bobbymckinney/hall_measurement/README.md

# hall_measurement

This project is for the measurement of the hall coefficient and carrier concentration of thermoelectric materials.
