bobbymckinney/hall_measurement/setup/Matrix Card Schematic.pptx

Resistivity/Hall Effect Matrix Card – Keithley 7709

Wiring Color Code
A – Red
B – Black
C – Blue
D – Green
I – White
V – Yellow

- Row/Column

- Channel

- Wiring Pin

(#)

A

C

Sample

B

D

Hi

(24)

(08)

1

Lo

Hi

(41)

2

(25)

Lo

Hi

(26)

3

(10)

Lo

Hi

(43)

4

(27)

Lo

Hi

(28)

5

(12)

Lo

Hi

(45)

6

(29)

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
(35)

(19)

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
(20)

(04)

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
## Slide 2

Resistivity Measurement Sequence – RAB, CD

1. Current Off
2. Short Card – Close 17, 25, 26, 27, 28, 29, 30
3. Prepare Measurement - Open 25, 27, 28, 29, 30
4. Current On, Delay, Measure Voltage
5. Current Reverse, Delay, Measure Voltage
6. Current Off
7. Short Card – Close 25, 27, 28, 29, 30

## Slide 3

Resistivity Measurement Sequence – RCD, AB

1. Current Off
2. Short Card – Close 17, 25, 26, 27, 28, 29, 30
3. Prepare Measurement – Close 18
4. Prepare Measurement – Open 17, 26, 27, 28, 29, 30
5. Current On, Delay, Measure Voltage
6. Current Reverse, Delay, Measure Voltage
7. Current Off
8. Short Card – Close 17, 26, 27, 28, 29, 30
9. Finish – Open 18

## Slide 4

Resistivity Measurement Sequence – RAC,BD

1. Current Off
2. Short Card – Close 17, 25, 26, 27, 28, 29, 30
3. Prepare Measurement – Close 19
4. Prepare Measurement – Open 17, 25, 26, 27, 29, 30
5. Current On, Delay, Measure Voltage
6. Current Reverse, Delay, Measure Voltage
7. Current Off
8. Short Card – Close 17, 25, 26, 27, 29, 30
9. Finish – Open 19

## Slide 5

Resistivity Measurement Sequence – RBD,AC

1. Current Off
2. Short Card – Close 17, 25, 26, 27, 28, 29, 30
3. Prepare Measurement – Close 20
4. Prepare Measurement – Open 17, 25, 26, 28, 29, 30
5. Current On, Delay, Measure Voltage
6. Current Reverse, Delay, Measure Voltage
7. Current Off
8. Short Card – Close 17, 25, 26, 28, 29, 30
9. Finish – Open 20

## Slide 6

Hall Effect Measurement Sequence – R±AD,BC

1. Current Off, B-Field Off
2. Short Card – Close 17, 25, 26, 27, 28, 29, 30
3. Prepare Measurement – Close 21
4. Prepare Measurement – Open 17, 25, 26, 27, 28, 29
5. Current On, B-Field On, Delay, Measure Voltage
6. Current Reverse, Delay, Measure Voltage
7. B-Field Reverse, Delay, Measure Voltage,
8. Current Reverse, Delay, Measure Voltage
9. Current Off, B-Field Off
10. Short Card – Close 17, 25, 26, 27, 28, 29
11. Finish – Open 21

## Slide 7

Hall Effect Measurement Sequence – R±BC,AD

1. Current Off, B-Field Off
2. Short Card – Close 17, 25, 26, 27, 28, 29, 30
3. Prepare Measurement – Close 22
4. Prepare Measurement – Open 17, 25, 26, 27, 28, 30
5. Current On, B-Field On, Delay, Measure Voltage
6. Current Reverse, Delay, Measure Voltage
7. B-Field Reverse, Delay, Measure Voltage,
8. Current Reverse, Delay, Measure Voltage
9. Current Off, B-Field Off
10. Short Card – Close 17, 25, 26, 27, 28, 30
11. Finish – Open 22
