bobbymckinney/hall_measurement/setup/hightemp_solidworks/hightemphall_assembly_2.SLDASM

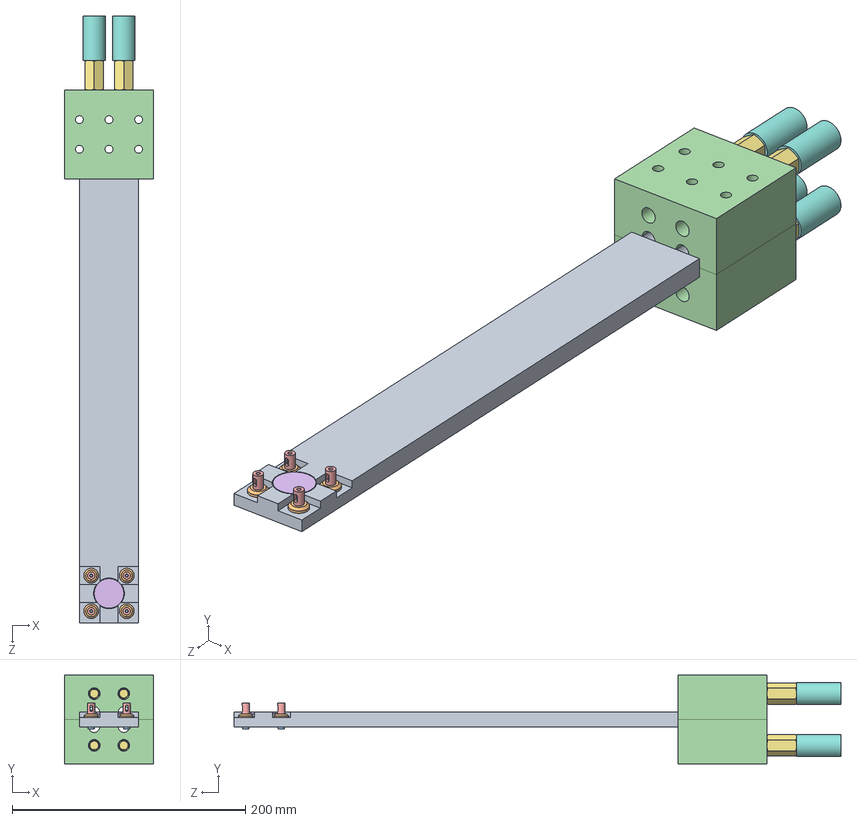
[picture p1: CAD file, 2016-02-09]
setup/hightemp_solidworks/hightemphall_assembly_2.SLDASM
76.2 x 76.2 x 520.7 mm
tongue
ceramic_flange_spacer x 8
titanium_screws x 4
block1 x 2
titanium_towers x 4
ceramic_round
stainlessSteel_standoff x 4
ceramic_standoff_small x 4
