bobbymckinney/hall_measurement/setup/hightemp_solidworks/hightemphall_assembly.SLDASM

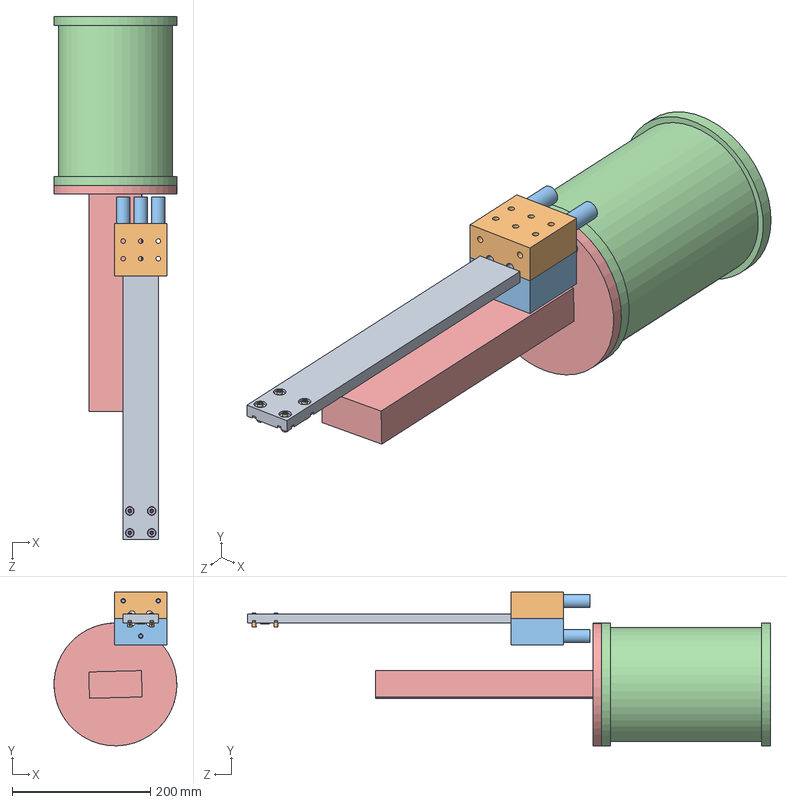
[picture p2: CAD file, 2016-02-09]
setup/hightemp_solidworks/hightemphall_assembly.SLDASM
177.7 x 222.4 x 756.7 mm
tongue
block1
ceramic_standoff_small x 3
ceramic_round
example_sample
ceramic_washer_small x 4
titanium_screws x 4
ceramic_spacers x 4
ceramic_washer_large x 4
titanium_towers x 4
block2
vacuum_chamber
vacuum_chamber_bottom
