bobbymckinney/hall_measurement/setup/hightemp_solidworks/hightemphall_assembly_with_chamber.SLDASM

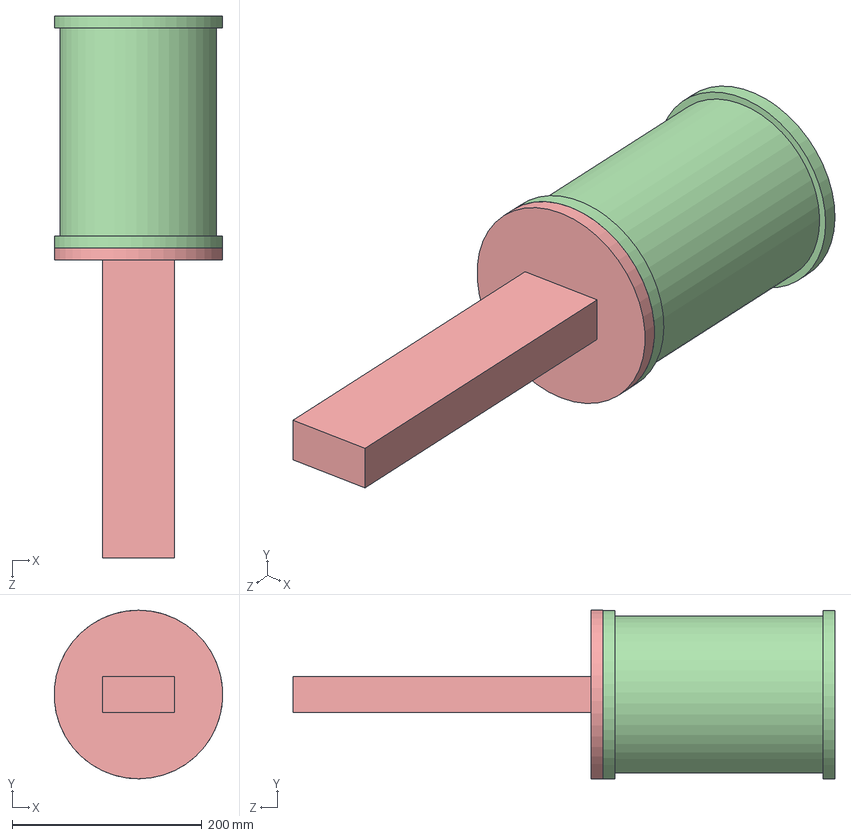
[picture p3: CAD file, 2016-02-09]
setup/hightemp_solidworks/hightemphall_assembly_with_chamber.SLDASM
177.7 x 177.8 x 571.5 mm
tongue
block1
ceramic_standoff_small x 3
ceramic_round
example_sample
ceramic_washer_small x 4
titanium_screws x 4
ceramic_spacers x 4
ceramic_washer_large x 4
titanium_towers x 4
block2
vacuum_chamber
vacuum_chamber_bottom
