bobbymckinney/hall_measurement/setup/hightemp_solidworks/ceramic_flange_spacer.SLDPRT

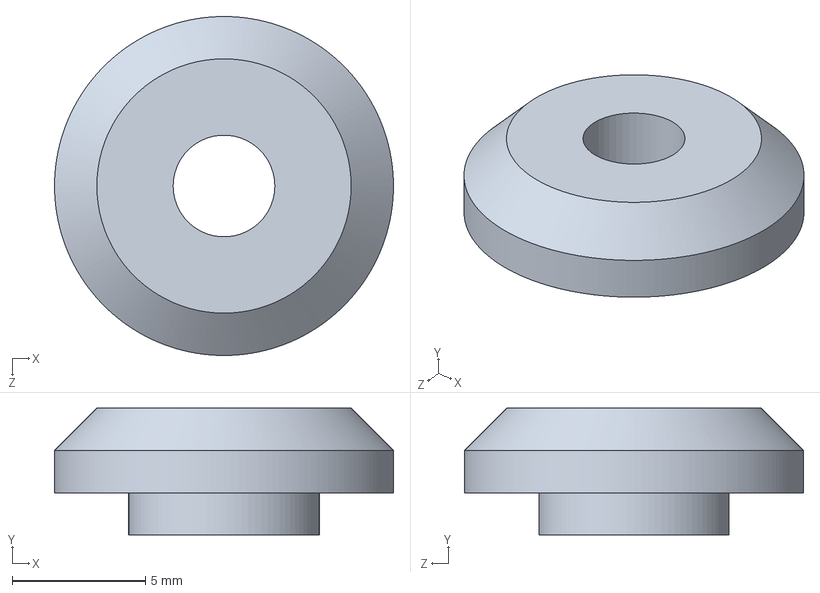
[picture p4: CAD file, 2016-02-09]
setup/hightemp_solidworks/ceramic_flange_spacer.SLDPRT
12.7 x 4.75 x 12.7 mm
