bobbymckinney/hall_measurement/setup/hightemp_solidworks/stainlessSteel_standoff.SLDPRT

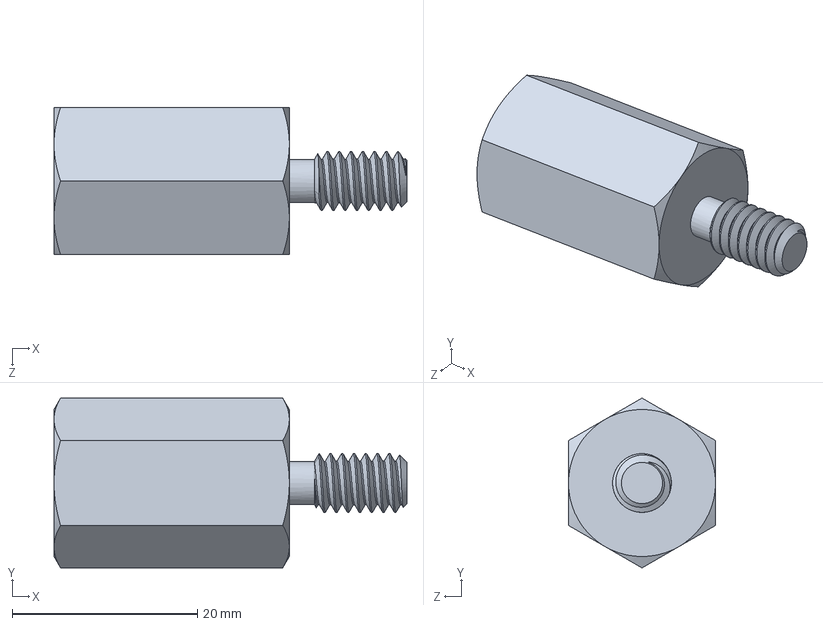
[picture p5: CAD file, 2016-02-09]
setup/hightemp_solidworks/stainlessSteel_standoff.SLDPRT
38.1 x 18.3 x 15.9 mm
