bobbymckinney/hall_measurement/setup/hightemp_solidworks/ceramic_round.SLDPRT

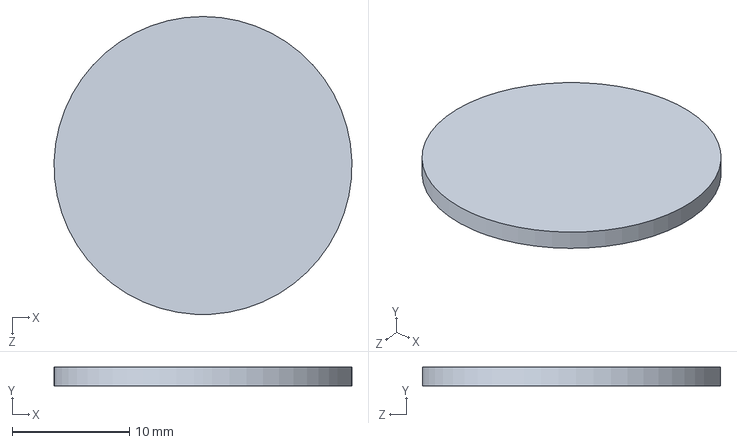
[picture p6: CAD file, 2016-02-09]
setup/hightemp_solidworks/ceramic_round.SLDPRT
25.4 x 1.59 x 25.4 mm
