bobbymckinney/hall_measurement/setup/hightemp_solidworks/tongue.SLDPRT

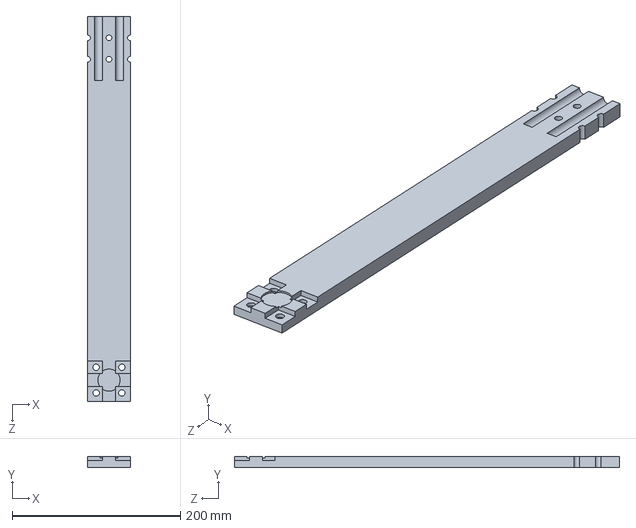
[picture p7: CAD file, 2016-02-09]
setup/hightemp_solidworks/tongue.SLDPRT
50.8 x 12.7 x 457.2 mm
