bobbymckinney/hall_measurement/setup/hightemp_solidworks/vacuum_chamber.SLDPRT

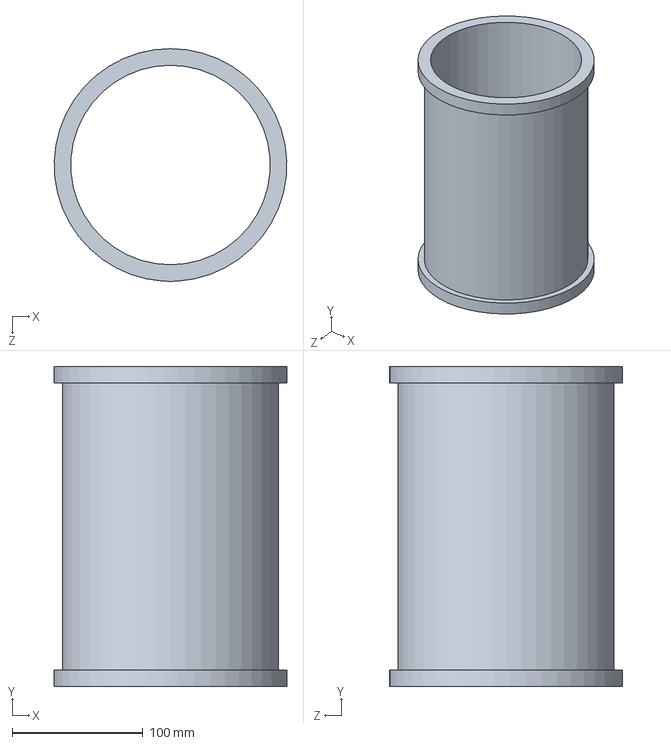
[picture p8: CAD file, 2016-02-09]
setup/hightemp_solidworks/vacuum_chamber.SLDPRT
177.7 x 244.5 x 177.8 mm
