bobbymckinney/hall_measurement/setup/hightemp_solidworks/block1.SLDPRT

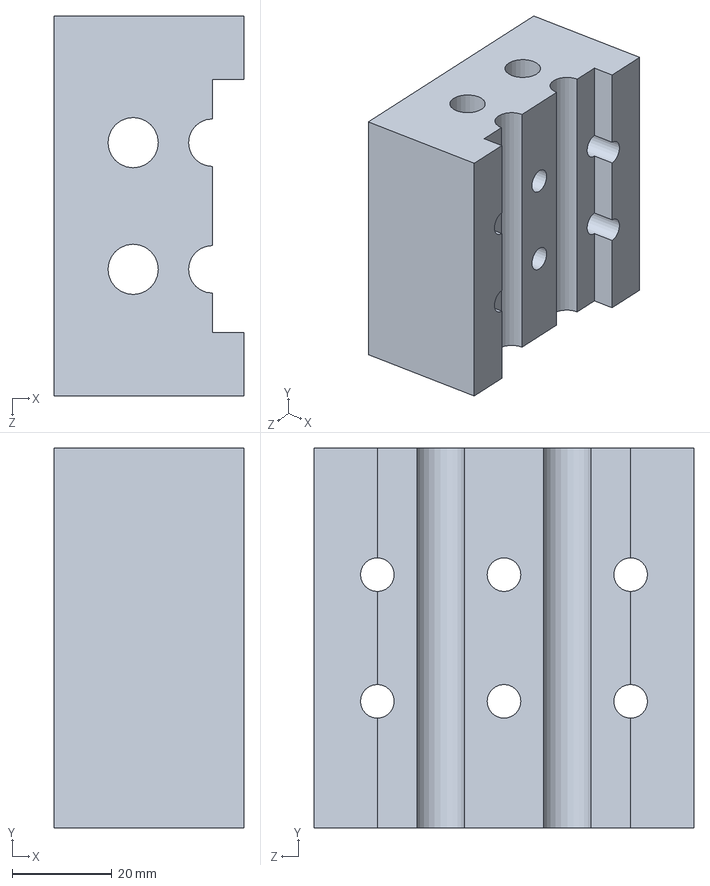
[picture p9: CAD file, 2016-02-09]
setup/hightemp_solidworks/block1.SLDPRT
38.1 x 76.2 x 76.2 mm
