bobbymckinney/hall_measurement/setup/hightemp_solidworks/ceramic_standoff_small.SLDPRT

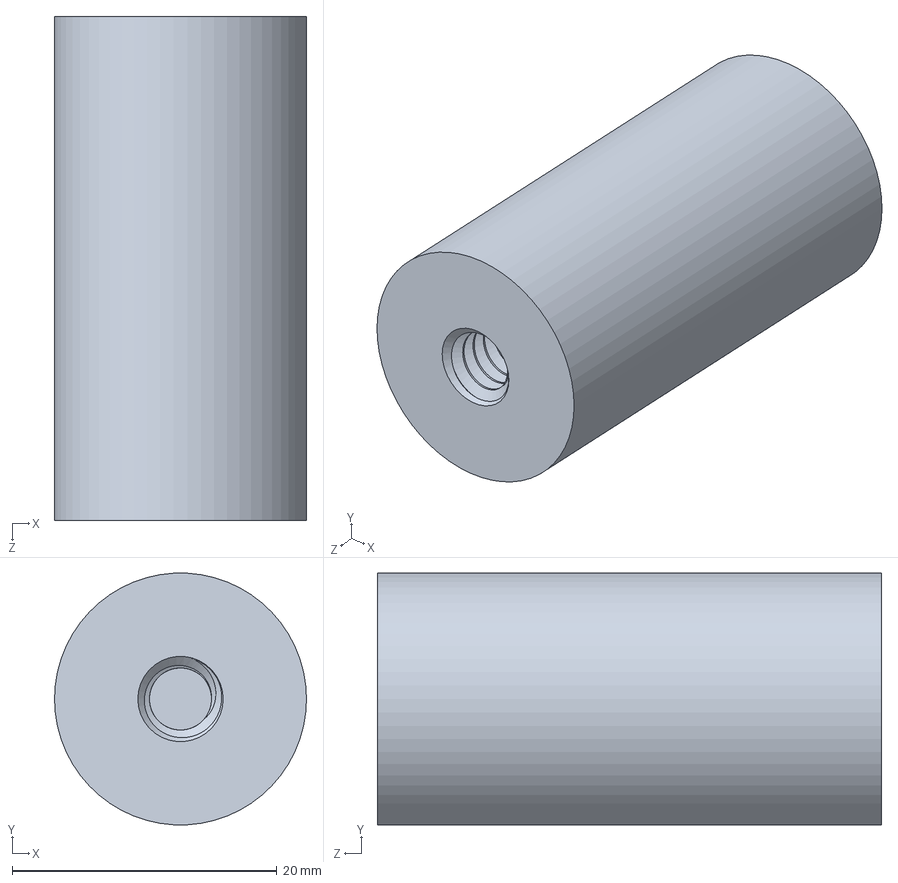
[picture p10: CAD file, 2016-02-09]
setup/hightemp_solidworks/ceramic_standoff_small.SLDPRT
19.1 x 19.0 x 38.1 mm
