bobbymckinney/hall_measurement/setup/hightemp_solidworks/vacuum_chamber_bottom.SLDPRT

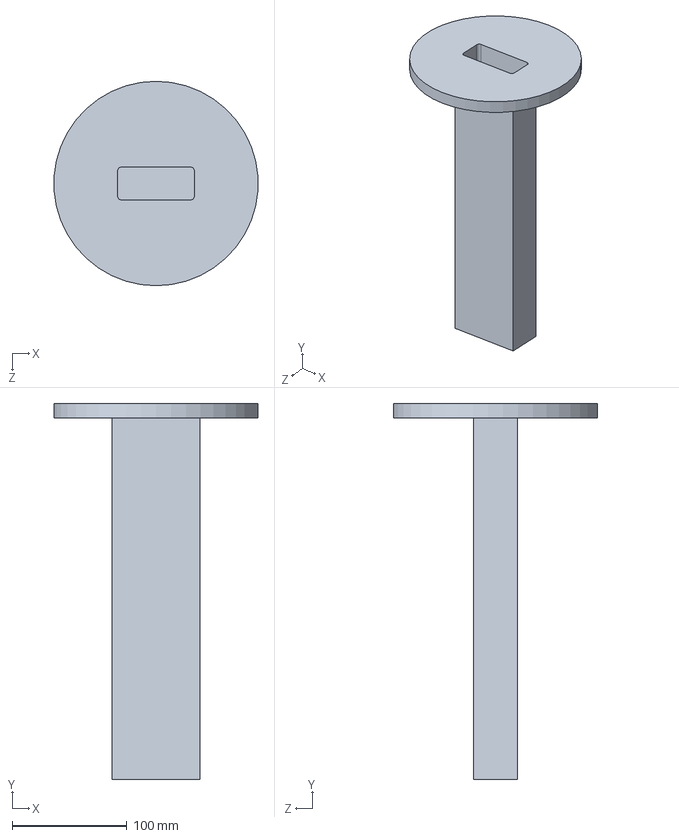
[picture p11: CAD file, 2016-02-09]
setup/hightemp_solidworks/vacuum_chamber_bottom.SLDPRT
177.3 x 327.0 x 177.8 mm
