bobbymckinney/hall_measurement/setup/hightemp_solidworks/ceramic_standoff_wide.SLDPRT

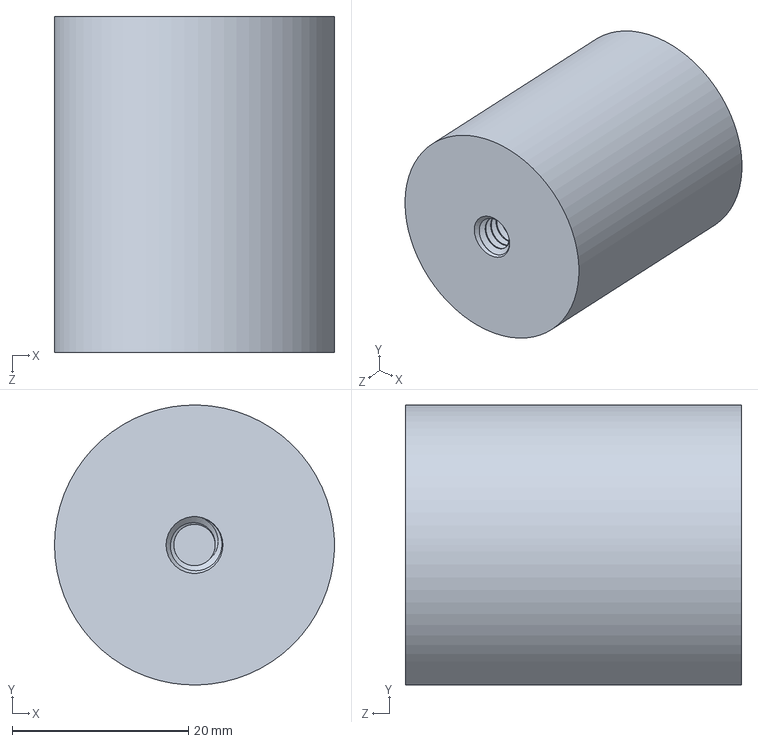
[picture p13: CAD file, 2016-02-09]
setup/hightemp_solidworks/ceramic_standoff_wide.SLDPRT
31.8 x 31.7 x 38.1 mm
