bobbymckinney/hall_measurement/setup/hightemp_solidworks/example_sample.SLDPRT

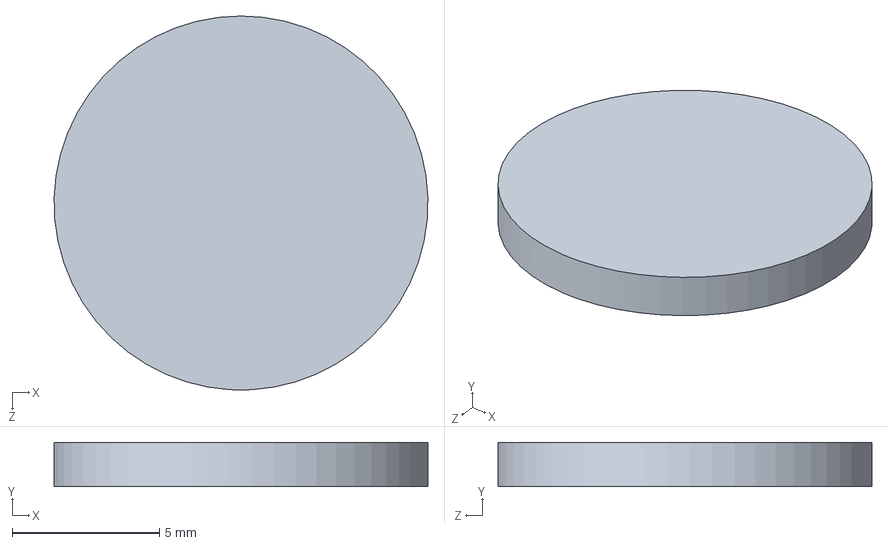
[picture p14: CAD file, 2016-02-09]
setup/hightemp_solidworks/example_sample.SLDPRT
12.7 x 1.50 x 12.7 mm
