bobbymckinney/hall_measurement/setup/hightemp_solidworks/titanium_towers.SLDPRT

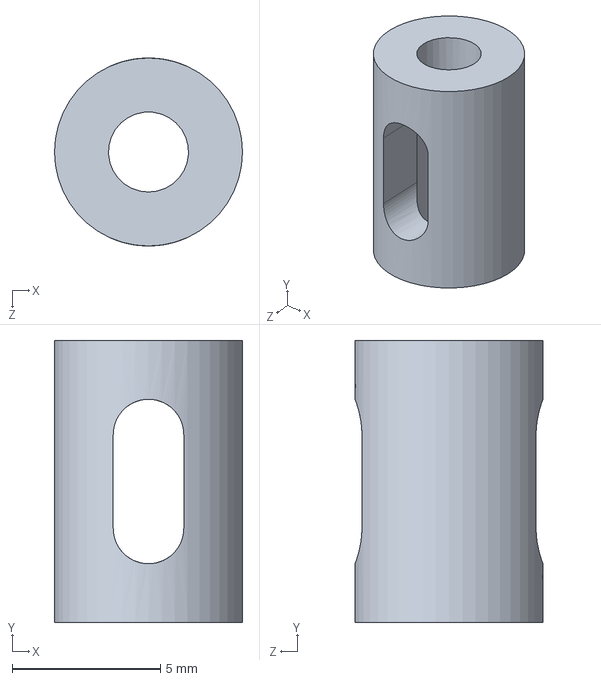
[picture p15: CAD file, 2016-02-09]
setup/hightemp_solidworks/titanium_towers.SLDPRT
6.35 x 9.53 x 6.35 mm
