bobbymckinney/hall_measurement/setup/hightemp_solidworks/ceramic_spacers.SLDPRT

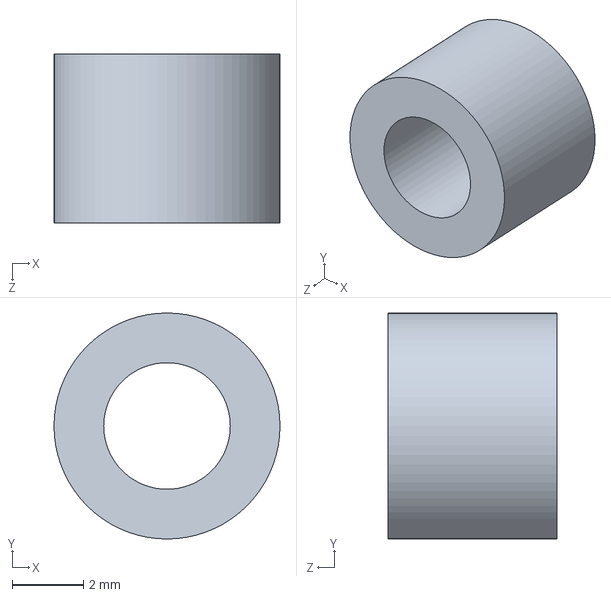
[picture p16: CAD file, 2016-02-09]
setup/hightemp_solidworks/ceramic_spacers.SLDPRT
6.35 x 6.35 x 4.76 mm
