bobbymckinney/hall_measurement/setup/hightemp_solidworks/ceramic_washer_small.SLDPRT

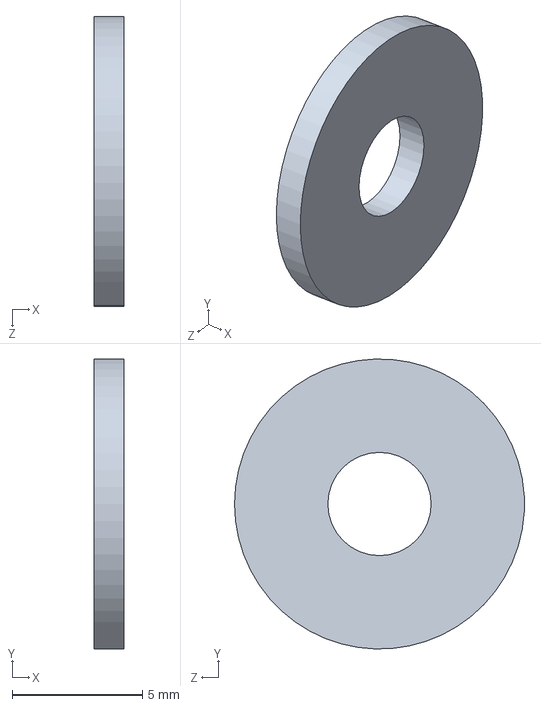
[picture p17: CAD file, 2016-02-09]
setup/hightemp_solidworks/ceramic_washer_small.SLDPRT
1.14 x 11.1 x 11.1 mm
