bobbymckinney/hall_measurement/(list of files, cad)

Other CAD files:
setup/hall_setup_cad.dwg
setup/hightemp_solidworks/ceramic_washer_large.SLDPRT
setup/hightemp_solidworks/titanium_screws.SLDPRT
