bobbymckinney/hall_measurement/setup/Rev. Sci. Instrum. 2012 Borup.pdf

Measurement of the electrical resistivity and Hall coefficient at high temperatures

Kasper A. Borup, (http://scitation.aip.org/search?value1=Kasper+A.+Borup&option1=author) Eric S. Toberer, (http://scitation.aip.org/search?value1=Eric+S.+Toberer&option1=author) Leslie D. Zoltan, (http://scitation.aip.org/search?value1=Leslie+D.+Zoltan&option1=author) George Nakatsukasa, (http://scitation.aip.org/search?value1=George+Nakatsukasa&option1=author) Michael Errico, (http://scitation.aip.org/search?value1=Michael+Errico&option1=author) Jean-Pierre Fleurial, (http://scitation.aip.org/search?value1=Jean-Pierre+Fleurial&option1=author) Bo B. Iversen, (http://scitation.aip.org/search?value1=Bo+B.+Iversen&option1=author) and G. Jeffrey Snyder (http://scitation.aip.org/search?value1=G.+Jeffrey+Snyder&option1=author)

Citation: Review of Scientific Instruments (http://scitation.aip.org/content/aip/journal/rsi?ver=pdfcov) 83, 123902 (2012); doi: 10.1063/1.4770124
View online: http://dx.doi.org/10.1063/1.4770124
View Table of Contents: http://scitation.aip.org/content/aip/journal/rsi/83/12?ver=pdfcov Published by the AIP Publishing (http://scitation.aip.org/content/aip?ver=pdfcov)

Articles you may be interested in
Measurement system of the Seebeck coefficient or of the electrical resistivity at high temperature (http://scitation.aip.org/content/aip/journal/rsi/84/10/10.1063/1.4823527?ver=pdfcov)
Rev. Sci. Instrum. 84, 105103 (2013); 10.1063/1.4823527

Appearance of a correlation between the Hall coefficient and electrical resistivity upon dihydrogenation of yttrium (http://scitation.aip.org/content/aip/journal/jap/108/8/10.1063/1.3500443?ver=pdfcov)
J. Appl. Phys. 108, 083719 (2010); 10.1063/1.3500443

Paraelectric Permittivity And Temperature Dependence Of Resistivity And Hall Coefficient In HighTc Metal Oxides (http://scitation.aip.org/content/aip/proceeding/aipcp/10.1063/1.2354801?ver=pdfcov)
AIP Conf. Proc. 850, 495 (2006); 10.1063/1.2354801

Experimental setup for the measurement of the electrical resistivity and thermopower of thin films and bulk materials (http://scitation.aip.org/content/aip/journal/rsi/76/5/10.1063/1.1912820?ver=pdfcov)
Rev. Sci. Instrum. 76, 053907 (2005); 10.1063/1.1912820

Resistivity and Hall voltage study of phosphorus segregation in polycrystalline Si 1x Ge x films (http://scitation.aip.org/content/aip/journal/jap/92/1/10.1063/1.1483923?ver=pdfcov)
J. Appl. Phys. 92, 168 (2002); 10.1063/1.1483923

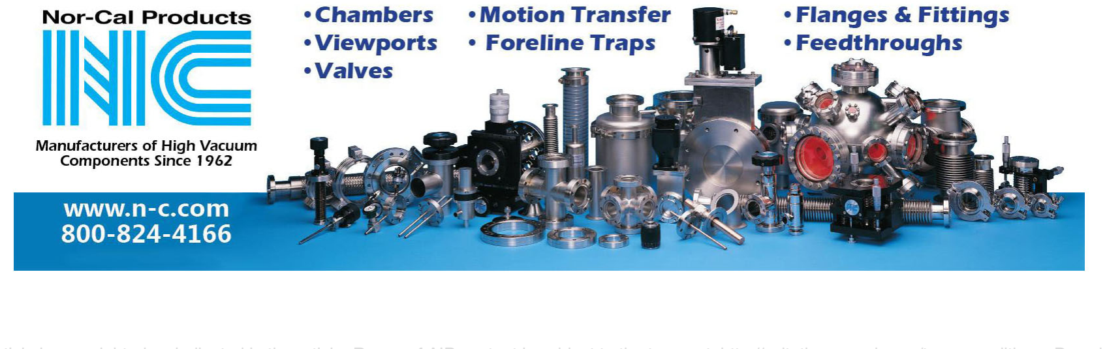
[picture p23: figure]

This article is copyrighted as indicated in the article. Reuse of AIP content is subject to the terms at: http://scitationnew.aip.org/termsconditions. Downloaded to IP: 138.67.199.67 On: Thu, 10 Jul 2014 23:15:00

REVIEW OF SCIENTIFIC INSTRUMENTS 83, 123902 (2012)

## Measurement of the electrical resistivity and Hall coefficient at high temperatures (http://dx.doi.org/10.1063/1.4770124)

Kasper A. Borup,¹ Eric S. Toberer,² Leslie D. Zoltan,³ George Nakatsukasa,³ Michael Errico,³ Jean-Pierre Fleurial,³ Bo B. Iversen,¹ and G. Jeffrey Snyder⁴,a) 1Center for Materials Crystallography, Department of Chemistry and iNANO, Aarhus University, Aarhus DK-8000, Denmark
2Department of Physics, Colorado School of Mines, Golden, Colorado 80401, USA
3Jet Propulsion Laboratory/California Institute of Technology, 4800 Oak Grove Drive, Pasadena, California 91109, USA
4Materials Science, California Institute of Technology, Pasadena, California 91125, USA
(Received 25 June 2012; accepted 21 November 2012; published online 14 December 2012)
The implementation of the van der Pauw (VDP) technique for combined high temperature measurement of the electrical resistivity and Hall coefficient is described. The VDP method is convenient for use since it accepts sample geometries compatible with other measurements. The technique is simple to use and can be used with samples showing a broad range of shapes and physical properties, from near insulators to metals. Three instruments utilizing the VDP method for measurement of heavily doped semiconductors, such as thermoelectrics, are discussed. © 2012 American Institute of Physics. [http://dx.doi.org/10.1063/1.4770124]
I. INTRODUCTION
The electrical resistivity and Hall coefficient are important materials properties. They play an important role in any field of research concerned with the electronic transport properties of materials such as semiconductors and metals. From the Hall coefficient, the charge carrier concentration can be directly calculated. By simultaneous measurement of the resistivity, the carrier mobility can also be inferred. The temperature dependence and magnitude of the carrier mobility makes it possible to extract information about the scattering mechanisms.¹ This cannot be done with separated measurements of the resistivity and Hall coefficient.
With the traditional bar shaped samples, six contacts are needed for simultaneous measurement of the resistivity and Hall coefficient. Additionally, all dimensions of the sample and the distance between the contacts for resistance measurement need to be known. With the van der Pauw (VDP) technique, only four contacts are needed and only the sample thickness is necessary to calculate the resistivity.² The sample geometry is also suitable for other transport measurements such as flash diffusivity.
Few systems implement the VDP technique for combined high temperature resistivity and Hall coefficient measurements.³⁻⁵ A number of reports exist on systems utilizing other methods and sample geometries for both direct current (dc)⁶⁻⁸ and alternating current (ac)⁹⁻¹⁵ measurements. In this paper, we describe some of the challenges encountered when designing a high temperature resistivity and Hall effect apparatus based on the VDP geometry and outline general solutions that greatly facilitate the use of this method at high temperatures. Specific implementation of these solutions is assessed for three high temperature systems at NASA-JPL,

a)Author to whom correspondence should be addressed. Electronic mail: jsnyder@caltech.edu.

Caltech, and Aarhus University. All of these systems were designed for thermoelectric research; nevertheless, the general design rules are expected to hold regardless of application.

II. MEASUREMENT BACKGROUND
Traditional measurements of the electrical resistivity utilize a four-point bar geometry (Figure 1(a)), where an electrical current is applied at or near the ends and the voltage is measured between two points where the current is uniform. Here, the distance between the contacts and cross-sectional area are critical geometric parameters in converting the measured resistance to resistivity. As virtually no current flow through the voltage contacts when such a four-point method is used, there is normally no error due to contact resistance.
A. Van der Pauw method
Alternatively, van der Pauw showed that the resistivity of an isotropic, homogeneous flat sample could be determined from four probes located arbitrarily around the edge through conformal mapping mathematics.², 16 Here, the specific probe location is less critical to reliable measurements, but the sample thickness remains important. Instead of measuring the distance between the contacts, the in-plane geometric factor is determined by switching the probes used for current and voltage.
When measuring the resistivity using the van der Pauw approach, current between two adjacent probes on the sample edge induces a voltage between two additional probes on the edge of the sample. This is shown in panel (c), a current is passed from contact p to o, while the voltage is measured between contacts m and n resulting in a resistance Rpo,mn = Vmn/Ipo. Due to symmetry, reversing the polarity of both the voltmeter and current source or interchanging the voltmeter and current source results in the same resistance.
0034-6748/2012/83(12)/123902/7/$30.00 | © 2012 American Institute of Physics 83, 123902-1

123902-2 | Borup et al. | Rev. Sci. Instrum. 83, 123902 (2012)

This resistance is called RA. Measuring all four resistances
and using the average reduces the effect of imperfect contacts
and inhomogeneous samples but is not strictly necessary.¹⁷, 18
Likewise, using the contact arrangement in panel (d), RB = Rno,mp and its three analogs can be measured. RB is in general different from RA. The two resistances fulfill the VDP relationship,²
exp !
| −πdRA ρ

"

+ exp!
−πdRB
ρ

"
= 1. | (1)

Here, ρ is the sample resistivity and d its thickness. The VDP relationship cannot be solved analytically for ρ except for the special case where RA and RB are identical. Instead, a standard numerical method such as binary search or the Newton-Raphson method is used.

B. Hall coefficient
In an isotropic material, the Hall coefficient is a measure of the induced voltage orthogonal to both an electric current and magnetic field.¹⁹ The typical four-point bar geometry is shown in Figure 1(b), with the magnetic field normal to the sample surface. Thus, in a traditional bar geometry, five or six leads are required to measure both the resistivity and Hall coefficient. The ratio of the induced transverse voltage to the current can be described as a resistance Rmn,qr = Vqr/Imn. The Hall coefficient is generally described as RH = Rmn,qrd/B where d is the sample thickness (in direction of magnetic induction B); however, care must be taken to avoid Ohmic voltage signal and the magnetic response may not be linear in B (both discussed below).

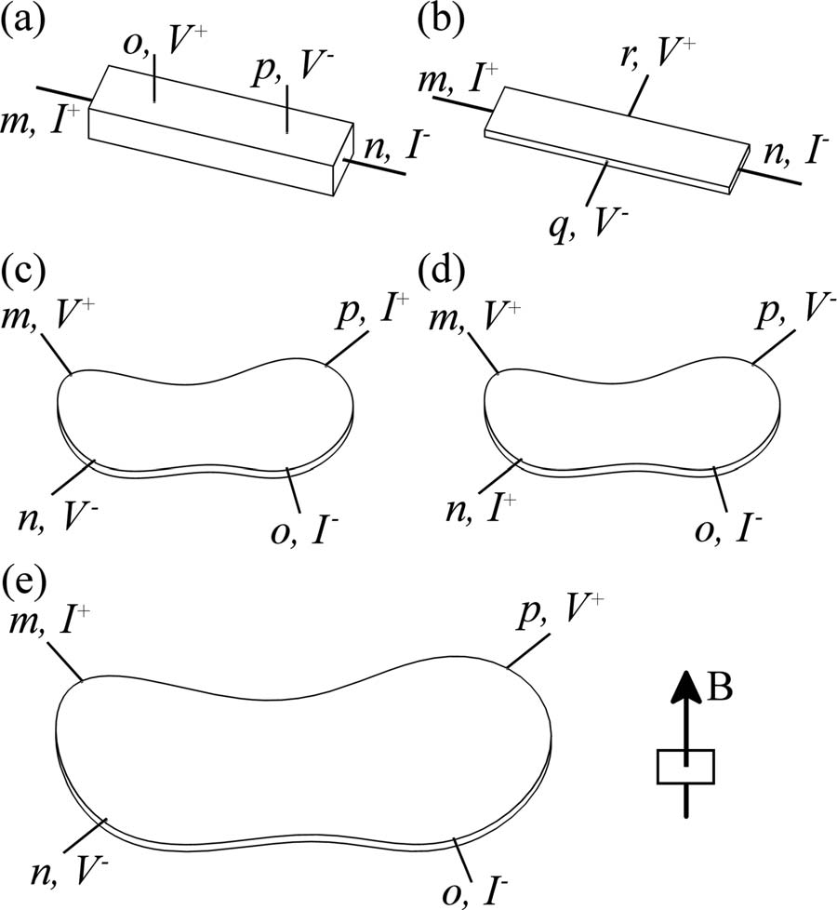
[picture p24: figure]

FIG. 1. Common sample geometries. (a) Preferred geometry for four-probe resistivity measurements, (b) common geometry for a Hall effect measurement, resistance measurements, (c) and (d) arbitrarily shaped lamella for VDP measurements showing contact arrangements for two resistance measurements, and (e) contact arrangement for a Hall effect measurement with the VDP method. The arrow in the bottom right corner indicates the positive direction of the magnetic field in panels (b) and (e).

With the van der Pauw geometry, the Hall coefficient can be obtained from the same four contacts used in the resistivity measurement. A current is passed diagonally across the sample, which is in a magnetic field perpendicular to the sample plane. For example, RH = Rmo,npd/B (Figure 1(e)) is used for Hall effect measurement. Four identical measurements can be made with the current in both directions along both diagonals. The measurements are repeated for at least two field strengths, such as positive and negative fields to subtract the Ohmic voltage signal.

III. INSTRUMENT SETUP AND MEASUREMENT PROCEDURES
A. Instrument geometry
A high temperature van der Pauw system requires a sample stage, heater, magnet, and associated electronics. However, the geometry and high temperature material selection can pose a challenge. This is further exacerbated when the sample must be kept under vacuum or a controlled environment via an enclosure. The following describes general design requirements for each of these components and the specific implementations which have been chosen in the three systems reviewed here.

### 1. Magnet

The magnet can be either a cryostat magnet or an electromagnet. A cryostat magnet usually has a narrow, cylindrical sample space within the superconducting coil where the magnetic field is directed along this cylindrical axis. This gives very limited space in the sample plane perpendicular to the magnetic field and limits space for contacts, which is unsuitable for large samples. In an electromagnet, there is more space perpendicular to the magnetic field but the pole gap should be small to allow for a high magnetic field, and hence restricts the space perpendicular to the sample plane. The electromagnet has the advantage that the direction of the field is more easily changed and the total accessible volume for the sample holder can be made larger.
The Caltech and JPL magnets are nearly identical electromagnets with different pole caps. The pole caps on the JPL magnet have much space between them (7.5 cm) to accommodate the sample stage, heater, and vacuum enclosure but do not focus the magnetic flux down as much as the Caltech magnet (2.5 cm between pole caps). The larger distance between the pole caps on the JPL magnet decreases the maximum field (approximately 1.0 T for JPL vs 2.0 T for Caltech). The Aarhus setup uses a different electromagnet with a 3.0 cm pole gap. This gives a 1.2 T field when the pole shoes are adjusted to give a homogeneous area (change less than 1.5%) of 3.0 cm in diameter.

### 2. Controlled atmosphere vessel

In order to prevent sample oxidation and sublimation, a controlled atmosphere vessel is needed. The atmosphere can either be vacuum or an inert cover gas. At high temperatures,

123902-3 | Borup et al. | Rev. Sci. Instrum. 83, 123902 (2012)

thermally insulating the heater from the walls of the vessel
is necessary to maintain the vessel’s mechanical strength and
stabilize the sample temperature. Choice of atmosphere (vacuum or an inert cover gas) is a critical decision. In a vacuum there is no convection, which facilitates insulating the vessel from the heaters. However, compared to a cover gas, the vacuum can increase evaporation from high vapor pressure samples. To counteract this, a layer of boron nitride spray can be applied after mounting the sample. A final consideration is the gap between the electromagnet pole caps. In both cases, the vessel and associated insulation will significantly decrease the available spaces between the pole caps.
In the systems described here, all three use vacuum atmosphere within the vessel. Radiation shielding is employed to minimize heat flow from the sample to the vessel.

### 3. Heating

There are in general three different strategies to heating the sample and probe: embedded heaters in the sample holder, radiative heating of the holder from inside the vessel, or heating the controlled atmosphere vessel from the outside. Heating from the outside is less efficient, requiring higher heater temperatures and requires more space for insulation. If outside heating is chosen, an inert gas atmosphere allows for better heat transfer to the sample than a vacuum.
When using resistance heaters, the field generated from the current should be reduced around the sample. If heating coils are used, a double helix with antiparallel current can be used to cancel out the generated field. A low current dc source is preferred since this minimizes the magnetic field in the heaters. An ac source will generate oscillating magnetic moments, which can cause vibrations when interacting with the field from the electromagnet. These vibrations can both damage the sample holder and increase the measurement noise due to changing capacitances of the leads and voltages induced by the oscillating magnetic field.
When using embedded heaters, it is particularly important to avoid temperature errors associated with radiative losses from the stage/sample. A thin metal sheet or foil (without electrically contacting the sample or electrical wiring) or equivalent insulation efficiently inhibits radiation from the sample and reduces the heat loss. In Figure 2(a), the heat shield around the stage is represented as a box with one end open. Several layers may be needed to improve the insulation, especially at high temperatures. If the innermost layer is in good thermal contact with the stage, the shielding will be close to the stage temperature and further stabilize the sample temperature.
The wider pole gap of the NASA-JPL system permits radiative heaters to surround the sample and a maximum temperature of 1000 ◦C. The heaters are simple resistive heaters. In contrast, the Caltech and Aarhus systems use heaters directly embedded into the sample stage. The Aarhus design uses a heater wire embedded into a ceramic binder within the stage while the Caltech heater is the size of a commercial cartridge heater and replaceable. Both systems exhibit a maximum temperature of 600 ◦C; this value is expected to increase with improved radiation shielding.

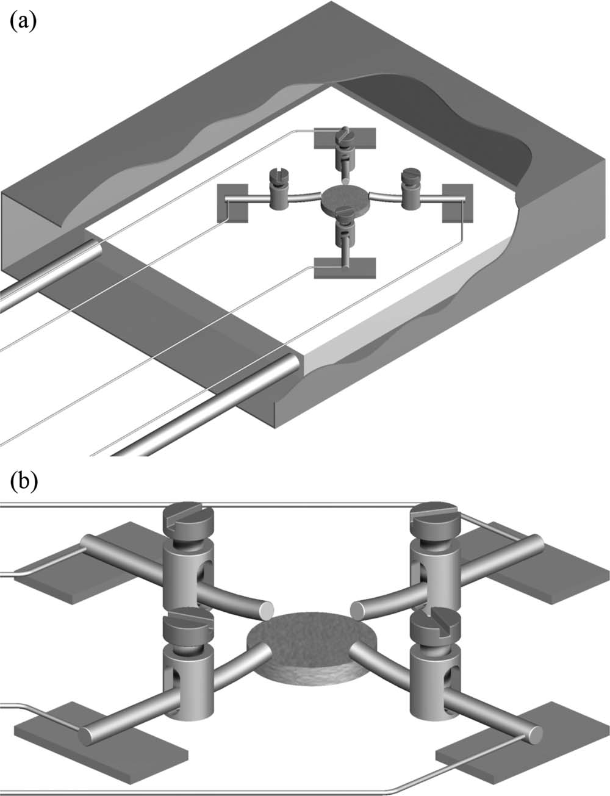
[picture p25: figure]

FIG. 2. Illustration of the sample holder. (a) The sample is mounted on a heated plate inside a heat shield. Two rods can be used to fix the sample holder between the poles of the electromagnet (not shown). (b) Zoom on the post-and-screw design. When the metal rods are pressed against the sample they bend elastically. This ensures good electrical contact during thermal expansion. The other end of the rods are either pressed against metal pads or connected directly to wires, in which case the pads are unnecessary. Both methods are shown for comparison.

### 4. Thermocouples

Thermocouples are critical for both controlling the heater response and for accurately measuring the sample temperature while data are being collected. Thermocouples (not shown) can be embedded in the sample holder below the sample. The thermocouple wires cannot be in direct contact with the sample since this interferes with the measurements.
In the Caltech and Aarhus systems, both the thermocouple and heaters are embedded in the stage. As the stage is a good thermal conductor, the heater PID control is quite good for these systems. The NASA-JPL system uses a thermocouple next to the sample that is attached to the stage. Thus, the thermocouple is radiatively coupled with the heaters, much like the sample.

### 5. Sample holder

The sample holder can be made from any electrically insulating material that can sustain the desired maximum temperature. It should also have sufficiently high thermal conductivity to reduce temperature gradients across the sample holder. Possible materials are ceramics such as boron nitride, alumina, and silicon carbide. Boron nitride is easily machin-

123902-4 | Borup et al. | Rev. Sci. Instrum. 83, 123902 (2012)

able and has a high thermal conductivity but a low mechanical
strength. Alumina and silicon carbide are hard to machine but
can be purchased as cements, which can be cast to the desired
shape. Figure 2(a) shows the principal components of a sample holder with embedded heaters for use in an electromagnet. The same general design can be used with radiated heaters in which case the heat shield is replaced by the heaters. The sample holder is rigidly mounted to fix the sample holder between the poles of the electromagnet.
Different approaches to the sample holder have been chosen. At Caltech, boron nitride is used for its machinability although it is expensive and the low mechanical strength has led to it requiring replacement after about 1000 uses. Holes bored into the boron nitride are used to contain custom cartridge heaters. The sample holder is rigidly attached by means of two rods. In Aarhus, the sample holder is cast from silicon carbide cement. Since silicon carbide cement is inexpensive, the heating coils are cast directly into the sample holder. This gives good heat transfer and eases temperature control but they cannot be changed if they break. To prolong the lifetime, thicker heating wire and higher currents are used to keep the wire temperature low. The wires are spatially separated from the sample to minimize the magnetic field and the coils are kept parallel to the sample plane. At JPL, refractory metal bolts are used to hold thick alumina plates together. The initial fabrication is not trivial, as the alumina requires a multitude of holes, but the stage is quite robust.
The stage can be designed to hold a sample on each side. In practice, the temperature control is typically the source of increased measurement time and a dual sample stage can double system throughput. If designed well, this will only increase the probe thickness slightly. The two sample design is best implemented in systems where the time required for a single measurement is low to keep the number of measurements high. Such a dual-stage has been implemented at NASA-JPL.

### 6. Electrical contacts to sample

The connections to the sample are made with four pressure contacts¹⁹ as seen in Figure 2(b). Screws and posts are used to press metal rods against the top edge of the sample making electrical contact and keeping the sample in place. This geometry allows for many sample sizes to be used, from a few millimeters in diameter to almost the diameter of the post arrangement as well as from thin films to ∼3 mm in thickness. This eliminates the need for contact glue or paste, thus decreasing the contact area. Contact glues and pastes can additionally react with or diffuse into the sample at high temperatures, leading to offset voltages and bad measurements. The post and screw design is additionally attractive, as it does not significantly increase stage thickness.
Errors arise in the measurements if the contacts have large areas or are far from the periphery.²⁰ The use of cylindrical metal wires at an angle to the sample plane can help to form point contacts just on the sample edge. Here, the top surface of the sample is higher than the contact pads surrounding the sample. The sample height can be adjusted with alumina plates to ensure the wires have the right angle. Alternatively, line contacts can be used on the side of the sample.³ Such contacts will limit the flexibility when placing the contacts and gives higher restrictions on the sample geometry.
In the Hall effect measurement, when the contacts are not placed exactly opposite of each other with respect to the current direction, the sample resistance will contribute to the measured voltage. While in principle this effect is subtracted it should be avoided as much as possible to reduce the measurement uncertainty and noise. Errors also arise if the distance between two contacts becomes comparable to the sample thickness. For square and rectangular samples, the contacts should be made to the corners rather than the sides.²¹ The measurement error is expected to be proportional to sample thickness over diameter.
The correct choice of material for the metal contacts is crucial for obtaining high accuracy measurements.¹⁹ The metal should be inert, maintain good mechanical and electrical properties in the used temperature range, and have a low Seebeck coefficient (low thermopower). Typically used metals such as silver and copper, and even nickel and platinum, can give reactions with many materials. Additionally, nickel is ferromagnetic and not preferred for Hall effect measurements. Instead metals with high melting points that are inert to most materials should be used. Some possible choices are niobium, molybdenum, tantalum, and tungsten. For the contacts to remain good during thermal expansion, the metal rods should be flexible and act as springs. This means that they cannot be too thin or thick, and should keep their mechanical strength and elasticity in the used temperature range. When the screws are tightened the rods should bend before the sample breaks. If the pressure screws and posts are made from the same material, they will fuse during high temperature operation. Possible materials are inert and non-magnetic metals including stainless steel and the above mentioned elements, among others. Since screws of stainless steel are cheap and easy to replace another material can be chosen for the posts.
We have found 1.0–1.5 mm molybdenum or tungsten wire have good electrical and mechanical properties and works well for thermoelectric measurements. It is strong and flexible and maintains its strength to very high temperatures, allowing for thin rods to be used. This minimizes the contact area.
The usual procedures for electrical wiring, insulation, and shielding should be used to reduce noise and stray voltages to acceptable levels.
B. Measurement strategy
For accurate measurement of the resistivity and Hall coefficient, a number of measurement offsets need to be removed. In the resistivity measurement, these include zero point offsets in the voltage versus current curve due to thermal voltages from the sample, measurement leads, and electronics. In a Hall coefficient measurement, offsets resulting from the sample resistance additionally arise when the contacts are not perfectly aligned.
When using dc measurements, the offset from thermal voltages can be removed by measuring the offset voltage before and after the resistance measurement, with the current turned off. By measuring it twice and using the average off-

123902-5 | Borup et al. | Rev. Sci. Instrum. 83, 123902 (2012)

set, linear changes in the voltage offset are taken into account.
The average offset voltage is subtracted from the voltage measurement before calculating the resistance.
If the current source has the ability to reverse the direction of the current, the delta method can be used instead. Here, the current is turned on in the positive direction, switched to negative and then back to positive. In each step, the current and voltage are measured as V +

1 and I +
1 for
positive current, V − and I

− for negative current, and finally
V +

2 and I +
2 for positive current. The resistance is then calculated as R = (V +
| 1 + V +

2 − 2V −)/(I +

1 + I +
2 − 2I −). These
both removes the offset voltage and combines one resistance measurement with its equivalent with reversed polarity of the current source and voltmeter. It is important to note that the circuit has to be the same for the measurements with positive and negative current for the offset voltage to be constant. Hence, the current should be reversed in the current source and not by switching a matrix card or other instruments between the current source and sample. Thermal offsets are removed automatically when using ac measurements, provided an appropriate frequency is chosen.
If RH changes linearly with B, the resistive offset in the Hall effect measurement can be removed by measuring the Hall voltage for several magnetic field strengths and subtracting the offset at B = 0. This increases the measurement time significantly, and often it is more convenient and sufficiently accurate to use only two field strengths. Reversing the field direction is preferred over turning the field on and off since it doubles the measured Hall resistance and removes magnetoresistance effects (voltages proportional to even powers of B) but still appropriate when the Hall effect is nonlinear (Hall voltages proportional to odd powers of B). Using thinner samples results in higher effective resistances which improves resolution, especially for low-mobility samples. Both the relative effect of noise proportional to the current and current independent thermal noise are lowered, resulting in a larger signal-to-noise ratio.
To reduce the measurement uncertainty, the contacts should be Ohmic and there should be no Shottky barrier. This is generally the case for high charge carrier concentrations as in heavily doped semiconductors and metals, especially at room temperature and above. For very low carrier concentration, the contacts may not be Ohmic, and measuring the I-V curve is necessary.
C. Other considerations
When making temperature varying measurements the temperature can either be continually ramped or increased in steps. Although increasing the temperature in steps makes the measurements more accurate, it also increases the measurement time considerably. If the temperature is ramped continually, the rate should be adjusted so the temperature does not change enough during measurements to substantially change the sample resistivity.
The measured resistivity is not affected much if the temperature changes slightly during the measurement; however, fine features in the resistivity versus temperature curve might be lost. If the contacts are slightly misaligned, the resistive offset in the Hall measurement will be very large and the Hall resistance can reduce to only a few percent of the measured value. If the temperature changes considerably between measuring with positive and negative fields, the resistance of the sample also changes and the resistive offset may not be subtracted off correctly.
Both ac and dc measurements can be used with the method described here. Alternating current measurements are often considered to give more precise measurements but are also harder to implement as shielding and capacitance considerations are different. An ac magnetic field with an ac test current through the sample¹³⁻¹⁵ can also be used for measurement of the Hall effect.

IV. MEASUREMENT EXAMPLE
Figure 3 shows a two-point (current and voltage across the same two contacts) I-V curve for a material with a charge carrier concentration of 2.8 × 10−18 cm−3. The current range typically used is covered, 0-500 mA. The voltage is measured across a contact-sample-contact double junction and is hence antisymmetric when reversing the current direction. Therefore, only positive currents are shown. No Schottky anomaly is visible. The sample is a Mg2Si intrinsic semiconductor and a slight decrease in resistance (∼5% corresponding to ∼2K temperature increase) can be ascribed to Joule heating at high currents (more than 1 W of Joule heating at the maximum current). Because this is a two-point measurement the resistance is a sum of the resistances of the leads, contacts, and the sample.
An example of a high temperature measurement is shown in Figure 4. A PbS sample was heated to ∼600 0◦C and cooled to room temperature at a rate of 100 K/hr while continually measuring the resistivity and Hall coefficient. The measurement was performed on both the Caltech (squares) and Aarhus (line) setups. The measurements agree quite well at room temperature. The slight disagreement in resistivity and Hall carrier concentration is most likely due to errors in the temperature measurement. The hysteresis in the Hall carrier

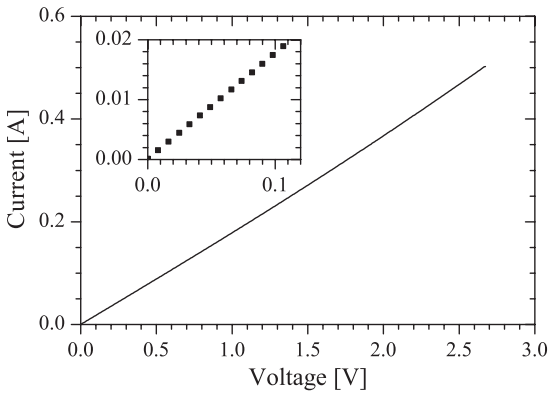
[picture p26: figure]

FIG. 3. I-V curve for metal contacts showing no Shottky anomaly. The current range, 0−500 mA, covers the currents typically used. The inset shows a zoom on the low current data to emphasize the absence of a Shottky anomaly. The sample used is n-type intrinsic Mg2Si with n ∼ 2.8 × 10−18 cm−3. Molybdenum has been chosen for the contacts.

123902-6 | Borup et al. | Rev. Sci. Instrum. 83, 123902 (2012)

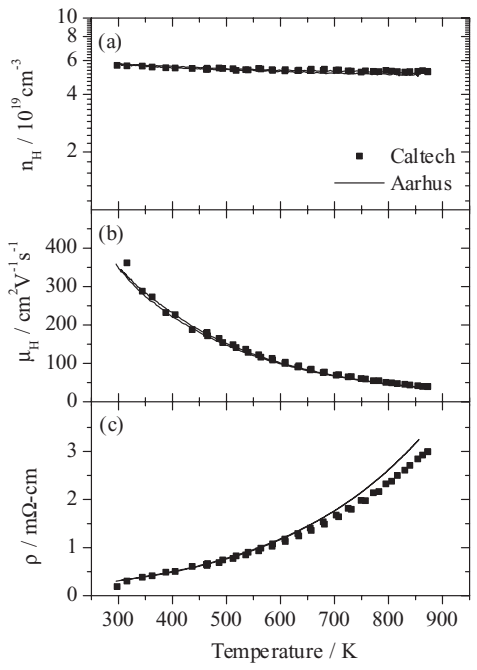
[picture p27: figure]
Caltech; Aarhus nH / 10¹⁹cm⁻³; Temperature / K

FIG. 4. Example of a measurement of (a) Hall carrier concentration, (b) Hall mobility and (c) electrical resistivity. The data were measured during heating and cooling to 600 ◦C on both the Caltech (squares) and Aarhus (line) setups. The sample is doped PbS.

concentration, most visible in the Aarhus data, is due to the sample resistivity changing during the measurement, as discussed above. The single parabolic band model is quite accurate for PbS and hence the change in Hall carrier concentration with temperature is small. With the method described herein the uncertainty in the resistivity and Hall coefficient is believed to be less than 5% for uniform samples. However, in the Hall effect measurement the noise can often exceed this, especially for low mobility or low carrier concentration samples. Additionally, bad alignment of the sample contacts or high heating rates may give systematic deviations in excess of this, as discussed in detail above. The error in the temperature measurements depends on the exact thermocouple placement, thermal resistance between sample and thermocouple and heat loss from the sample. In the apparati described here, the error in temperature measurements is believed to be less than 15 ◦C, including the thermocouple precision.

V. DISCUSSION
A. Measurement approach

### 1. Bar method

The most frequently used sample geometry for both resistivity and Hall effect measurements is the bar shape (Figs. 1(a) and 1(b)). For the measured resistivity to be accurate, the contacts o and p should be sufficiently far from contacts m and n to ensure parallel current paths. A primary source of uncertainty in these measurements is the ability to measure the geometric factors, namely, the distance l between contacts o and p as well as the cross-sectional area A of the bar. Often the contacts are attached with an electrical conducting adhesive, paste or solder, thus increasing the contact areas and making measurement of the distance between the contacts, l, ambiguous, leading to a primary source of inaccuracy. Additional contacts are needed for simultaneous resistivity and Hall measurements where large contacts r, q, may alter the current path for resistance measurements.

### 2. VDP method

In the VDP technique, explicit knowledge of the current paths is not needed, allowing for the resistivity and Hall coefficient to be measured on the same sample using the same contacts. The sample must be isotropic within the plane and of uniform thickness, may not contain any holes, and the contact areas have to be small compared to the surface area and ideally should be along the entire thickness at the edge. Like the traditional geometry, the sample is assumed to be homogeneous and without cracks. The sample can be polished to an even thickness, which can be measured sufficiently accurately not to lower the accuracy of the method significantly.
Like the traditional method, finite size of the contacts in the VDP leads to sources of error in the measurement. For a circular disc of diameter D, the error from a line contact extending a distance l along the sample periphery, away from the periphery, or a point contact placed away from the periphery, scales as #ρ/ρ ∝ l

2/D² and #RH/RH ∝ l/D. If l/D ≪ 1, the errors are to a first approximation additive¹⁶ and the error from a contact of finite area scales according to the same relationships. Tests have shown that the sample thickness should not exceed half the diameter for the technique to remain accurate.¹⁷

### 3. Hall effect

Inspired by the free electron model, the Hall carrier concentration can be defined from the Hall coefficient as nH = −1/eRH for electrons or pH = 1/eRH for holes where e is the electron charge. For materials with more complex band structures, nH simply becomes a measure of the Hall coefficient in units related to carrier concentration that can be negative or positive. Together with the resistivity, the Hall mobility can also be defined as µH = 1/nH eρ or µH = 1/pHeρ for electrons and holes, respectively. For complicated systems, we define µH = 1/nHeρ = RH/ρ as simply a measure of the Hall effect in units of mobility that would be negative for electrons and positive for holes. For materials where a simple single band model does not apply, the results should be used with care since they can be quite far from the real charge carrier concentrations and mobilities. This is frequently apparent when more than one carrier type is present. In this case, the Hall voltages of the two species partially cancel leading to low values of RH and µH or high nH where the magnitude and sign of the values depend in a complicated way on the transport parameters of the individual species.¹⁹

B. Application in thermoelectrics
In thermoelectrics, the electronic properties strongly affect the material performance. The efficiency of a

123902-7 | Borup et al. | Rev. Sci. Instrum. 83, 123902 (2012)

thermoelectric material is to first order proportional to the
thermoelectric figure of merit given by zT = S²T/κρ, where
S is the Seebeck coefficient, κ is the thermal conductivity, ρ
is the electrical resistivity, and T is the temperature. The Seebeck coefficient, electrical resistivity, and the electronic contribution to the thermal conductivity depend on the charge carrier concentration.²² Hence, the charge carrier concentration, being calculated from the Hall coefficient, is also important for full characterization of the material. Additionally, charge carrier scattering impacts both the electronic mobility (and thus resistivity) and the Seebeck coefficient. The temperature dependence of the mobility is one way to identify the dominant charge carrier scattering mechanism.
Within thermoelectrics, one of the experimental challenges is to accurately measure properties contributing to the figure of merit at high temperatures. Measuring individual properties on different samples can reduce the accuracy due to variations between the samples. Cutting a single sample between individual measurements can give the same problem due to sample inhomogeneities. The development of techniques utilizing the same sample geometry can hence increase the accuracy of the figure of merit substantially. Thermoelectric materials are often prepared as pressed pellets or as ingots made by the Bridgman-Stockbarger or Czochralski techniques. Polycrystalline pressed pellets of cubic materials are usually isotropic.²³ Polycrystalline pressed pellets of weakly anisotropic materials are often isotropic within experimental uncertainty.²⁴ Strongly anisotropic crystalline materials such as Bi2Te3 can be expected to be isotropic within the plane perpendicular to the pressing direction but can have very different transport properties along the pressing direction.²⁵ The properties of melt-grown ingots may have properties that change along the length of the ingot, and each slice may make a different study.
In all these cases, these circular disks are frequently used directly for measuring the thermal diffusivity in the laser flash technique²⁶ and can also be used for measuring the Seebeck coefficient²⁷, 28 along the same direction (parallel to the pressing direction). The same sample geometry can be used for measuring the resistivity and Hall coefficient in the VDP method but the measurements are performed in the plane of the disk. Hence, a complete characterization of a material can be obtained from the same sample without shaping it between individual measurements, provided the properties are isotropic.
These benefits reveal why the three thermoelectric research groups discussed herein have adopted the VDP method for high temperature measurements.

VI. SUMMARY
We have discussed general design guidelines for successfully implementing the VDP geometry in combined measurements of the resistivity and Hall coefficient at high temperature. Three instruments that were specifically designed for thermoelectric measurements are discussed in detail. The approach is convenient for measurements on thermoelectrics due to the compatibility of the sample geometry with other measurements. Several overarching design principles and guidelines discussed herein are also equally applicable to traditional bar measurements at high temperature.

ACKNOWLEDGMENTS
We gratefully acknowledge the assistance of the NASA-JPL thermoelectrics group for design, initial development, and testing, as well as funding for this project. The work was supported by the Danish National Research Foundation (Center for Materials Crystallography) and the Danish Strategic Research Council (Center for Energy Materials). E.S.T. acknowledges support from the U.S. National Science Foundation (NSF) MRSEC program—REMRSEC Center, Grant No. DMR-0820518. G.J.S acknowledges support of Fred Harris and others at BSST/Amerigon during the fabrication of the Caltech system.

1V. I. Fistul, Heavily Doped Semiconductors (Plenum, New York, 1969). 2L. J. van der Pauw, Philips Res. Rep. 13, 1 (1958). 3C. Wood, A. Lockwood, A. Chmielewski, J. Parker, and A. Zoltan, Rev.

Sci. Instrum. (http://dx.doi.org/10.1063/1.1137581) 55, 110 (1984). 4J. A. McCormac and J.-P. Fleurial, in Modern Perspectives on Thermo-

electrics and Related Materials Symposium (Materials Research Society, Anaheim, CA, 1991), p. 135.
5M. Morvic, in Proceedings of the Modern Perspectives on Thermoelectrics and Related Materials Symposium, Smolenice Castle, Slovakia, 2000 (http://dx.doi.org/10.1109/asdam.2000.889512) (IEEE, 2000), p. 327.
6T. M. Dauphinee and E. Mooser, Rev. Sci. Instrum. (http://dx.doi.org/10.1063/1.1715281) 26, 660 (1955). 7C. M. Hurd, J. Sci. Instrum. 42, 465 (1965). 8D. M. Rowe and R. W. Bunce, J. Phys. E 4, 902 (1971). 9G. L. Guthrie, Rev. Sci. Instrum. 36, 1177 (1965). 10J. M. Lavine, Rev. Sci. Instrum. 29, 970 (1958). 11E. E. Olson and J. E. Wertz, Rev. Sci. Instrum. 41, 419 (1970). 12E. M. Pell and R. L. Sproull, Rev. Sci. Instrum. 23, 548 (1952). 13T. Kaneda, S. Kobayash, and K. Shimoda, Jpn. J. Appl. Phys. 12, 1335

(1973).
14N. Z. Lupu, N. M. Tallan, and D. S. Tannhaus, Rev. Sci. Instrum. (http://dx.doi.org/10.1063/1.1720631) 38, 1658 (1967).
15B. R. Russell and C. Wahlig, Rev. Sci. Instrum. (http://dx.doi.org/10.1063/1.1745493) 21, 1028 (1950). 16L. J. van der Pauw, Philips Tech. Rev. 20, 220 (1958). 17C. Kasl and M. J. R. Hoch, Rev. Sci. Instrum. 76, 033907 (2005). 18D. W. Koon and C. J. Knickerbocker, Rev. Sci. Instrum. 63, 207 (1992). 19E. H. Putley, The Hall Effect and Related Phenomena (Butterworths,

London, 1960).
20C. J. Vineis, T. C. Harman, S. D. Calawa, M. P. Walsh, R. E. Reeder, R. Singh, and A. Shakouri, Phys. Rev. B (http://dx.doi.org/10.1103/PhysRevB.77.235202) 77, 235202 (2008). 21D. W. Koon and C. J. Knickerbocker, Rev. Sci. Instrum. 64, 510 (1993). 22G. J. Snyder and E. S. Toberer, Nature Mater. 7, 105 (2008). 23H. Wang, Y. Pei, A. D. LaLonde, and G. J. Snyder, Proc. Natl. Acad. Sci.

U.S.A. (http://dx.doi.org/10.1073/pnas.1111419109) 109, 9705 (2012). 24A. Zevalkink, W. Zeier, G. Pomrehn, E. Schechtel, W. Tremel, and G. J.

Snyder, Energy Environ. Sci. (http://dx.doi.org/10.1039/C2EE22378C) 5, 9121 (2012). 25L. P. Hu, X. H. Liu, H. H. Xie, J. J. Shen, T. J. Zhu, and X. B. Zhao, Acta

Mater. (http://dx.doi.org/10.1016/j.actamat.2012.05.008) 60, 4431 (2012). 26C. B. Vining, A. Zoltan, and J. W. Vandersande, Int. J. Thermophys. 10,

259 (1989).
27C. Wood, D. Zoltan, and G. Stapfer, Rev. Sci. Instrum. (http://dx.doi.org/10.1063/1.1138213) 56, 719 (1985). 28S. Iwanaga, E. S. Toberer, A. LaLonde, and G. J. Snyder, Rev. Sci. Instrum.

82, 063905 (2011).
