bobbymckinney/hall_measurement/setup/Screenshot 2015-05-21 13.10.47.png

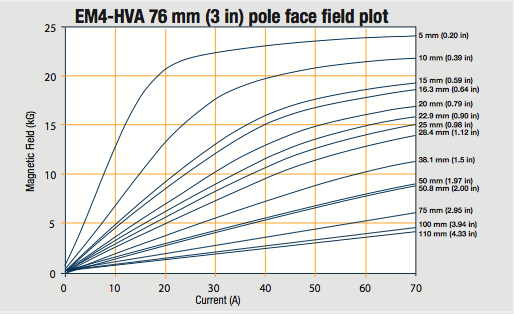
setup/Screenshot 2015-05-21 13.10.47.png
