bobbymckinney/hall_measurement/setup/Caltech_Hall/06017A004A PIN HOLDER.PDF

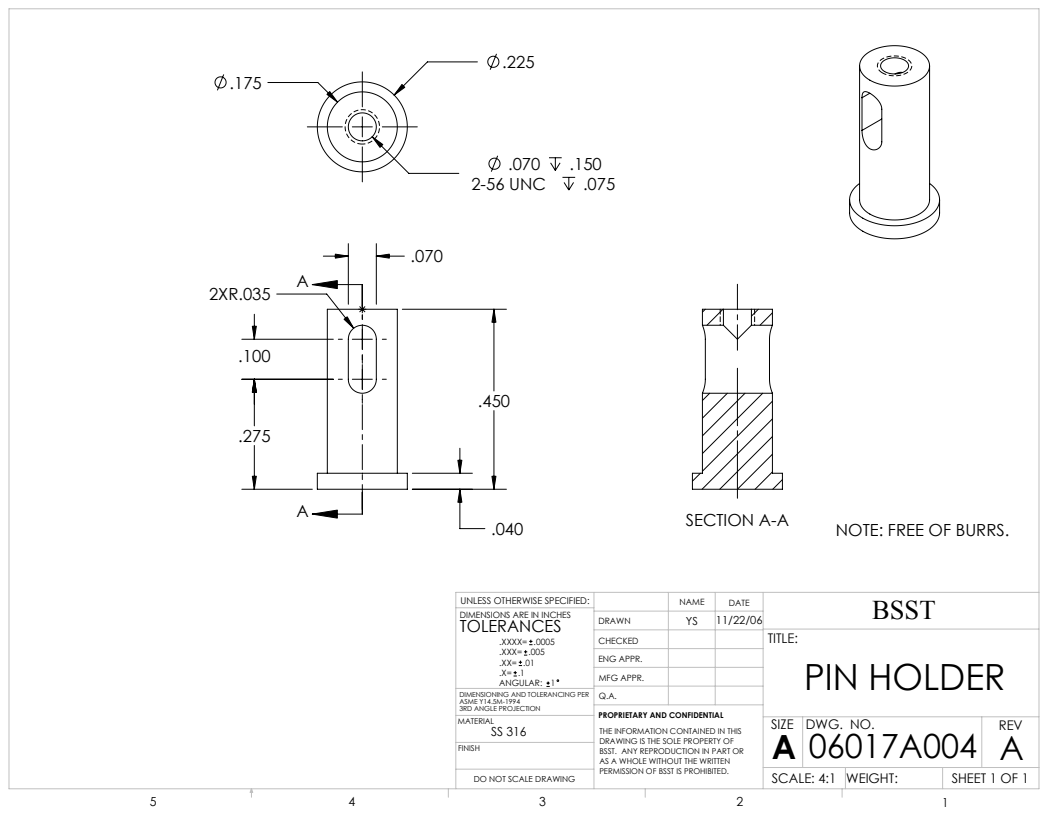
[picture p37: page 1]
2-56 UNC; SECTION A-A; NOTE: FREE OF BURRS.; PIN HOLDER; SHEET 1 OF 1; SCALE: 4:1 WEIGHT:; DWG. NO.; REV; BSST NAME; DATE; MFG APPR.; ENG APPR.; MATERIAL; PROPRIETARY AND CONFIDENTIAL; .XXXX= .0005 .XXX= .005 .XX= .01 .X= .1 ANGULAR: 1

UNLESS OTHERWISE SPECIFIED:
YS 11/22/06 DIMENSIONS ARE IN INCHES
TOLERANCES

DIMENSIONING AND TOLERANCING PER
ASME Y14.5M-1994
3RD ANGLE PROJECTION
FINISH

THE INFORMATION CONTAINED IN THIS
DRAWING IS THE SOLE PROPERTY OF
BSST. ANY REPRODUCTION IN PART OR
AS A WHOLE WITHOUT THE WRITTEN
PERMISSION OF BSST IS PROHIBITED.

DO NOT SCALE DRAWING
