bobbymckinney/hall_measurement/setup/Caltech_Hall/06017A010A SUPPORT BAR.PDF

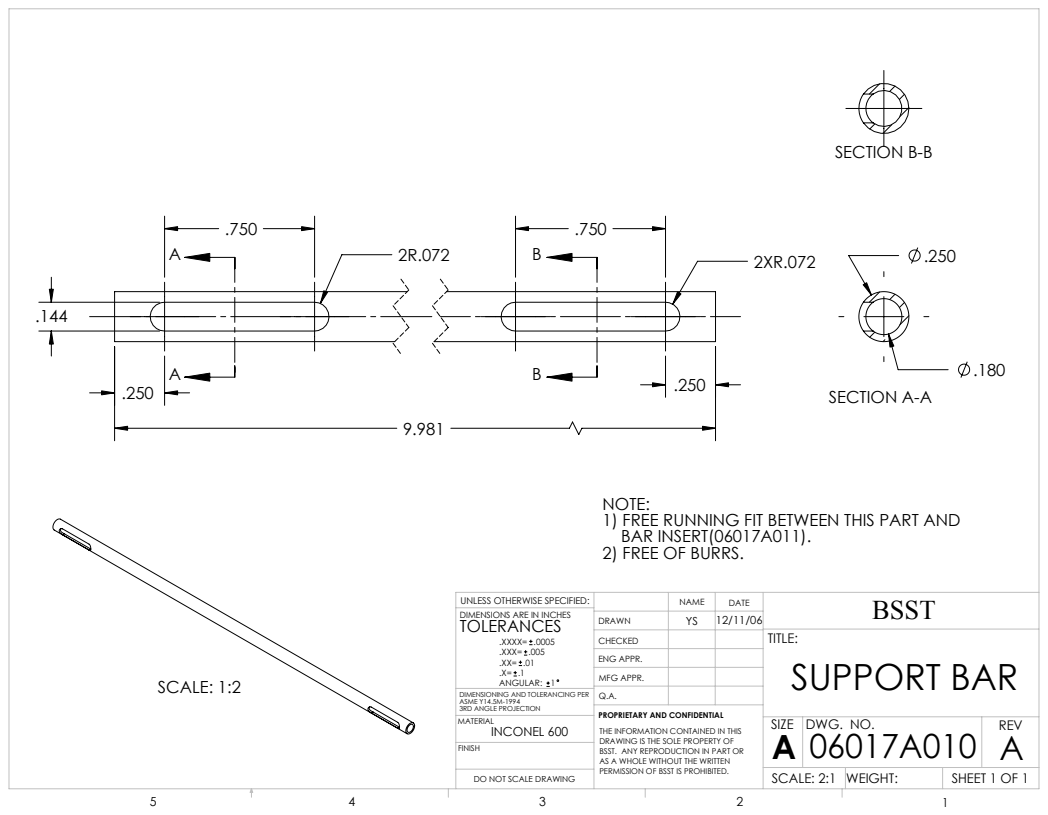
[picture p38: page 1]
SCALE: 1:2; SECTION A-A; SECTION B-B; SUPPORT BAR; SHEET 1 OF 1; SCALE: 2:1 WEIGHT:; DWG. NO.; REV; BSST NAME; DATE; MFG APPR.; ENG APPR.; MATERIAL; PROPRIETARY AND CONFIDENTIAL; .XXXX= .0005 .XXX= .005 .XX= .01 .X= .1 ANGULAR: 1

NOTE:
1) FREE RUNNING FIT BETWEEN THIS PART AND
BAR INSERT(06017A011).
2) FREE OF BURRS.

UNLESS OTHERWISE SPECIFIED:
YS 12/11/06 DIMENSIONS ARE IN INCHES
TOLERANCES

DIMENSIONING AND TOLERANCING PER
ASME Y14.5M-1994
3RD ANGLE PROJECTION
INCONEL 600
FINISH

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

DO NOT SCALE DRAWING
