bobbymckinney/hall_measurement/setup/Caltech_Hall/06017A011A BAR INSERT.PDF

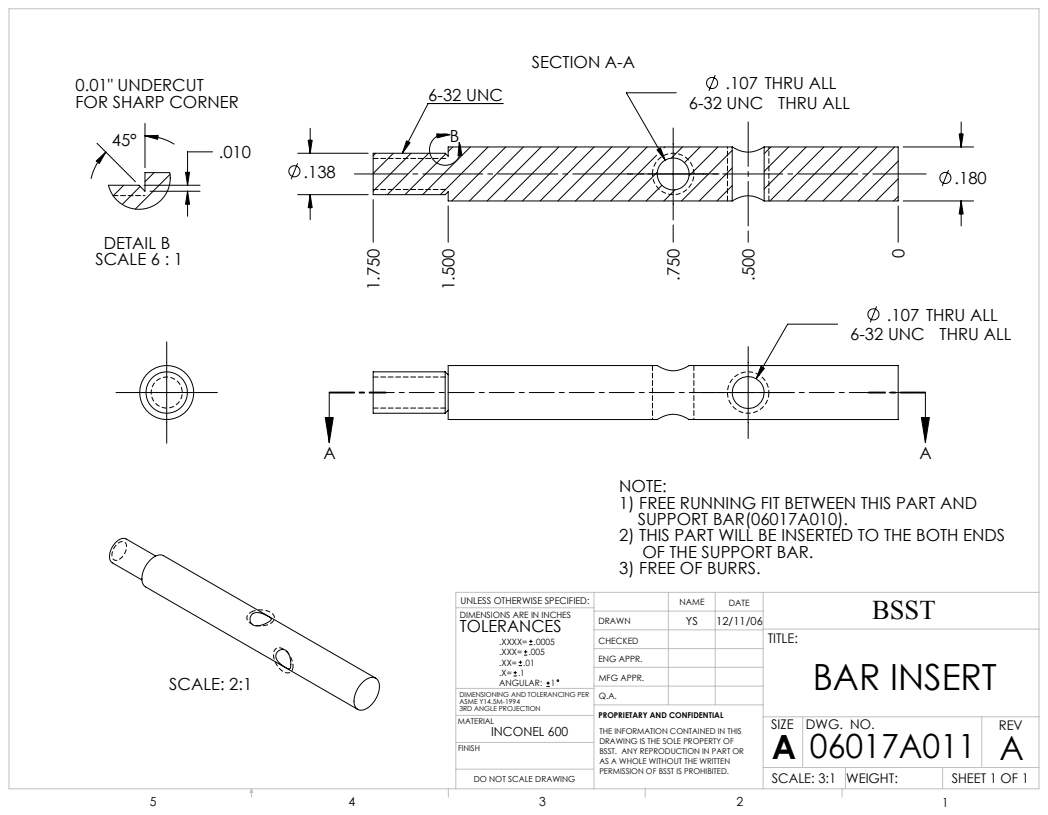
[picture p39: page 1]
SCALE: 2:1; SECTION A-A; 6-32 UNC; DETAIL B SCALE 6 : 1; BAR INSERT; SHEET 1 OF 1; SCALE: 3:1 WEIGHT:; DWG. NO.; REV; BSST NAME; DATE; MFG APPR.; ENG APPR.; MATERIAL; PROPRIETARY AND CONFIDENTIAL; 12/11/06 DIMENSIONS ARE IN INCHES; .XXXX= .0005 .XXX= .005 .XX= .01 .X= .1 ANGULAR: 1

.107 THRU ALL
6-32 UNC THRU ALL

0.01" UNDERCUT
FOR SHARP CORNER

NOTE:
1) FREE RUNNING FIT BETWEEN THIS PART AND
SUPPORT BAR(06017A010).
2) THIS PART WILL BE INSERTED TO THE BOTH ENDS
OF THE SUPPORT BAR.
3) FREE OF BURRS.

UNLESS OTHERWISE SPECIFIED:
TOLERANCES

DIMENSIONING AND TOLERANCING PER
ASME Y14.5M-1994
3RD ANGLE PROJECTION
INCONEL 600
FINISH

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

DO NOT SCALE DRAWING
