bobbymckinney/hall_measurement/setup/Caltech_Hall/06017B002B SUBSTRATE.PDF

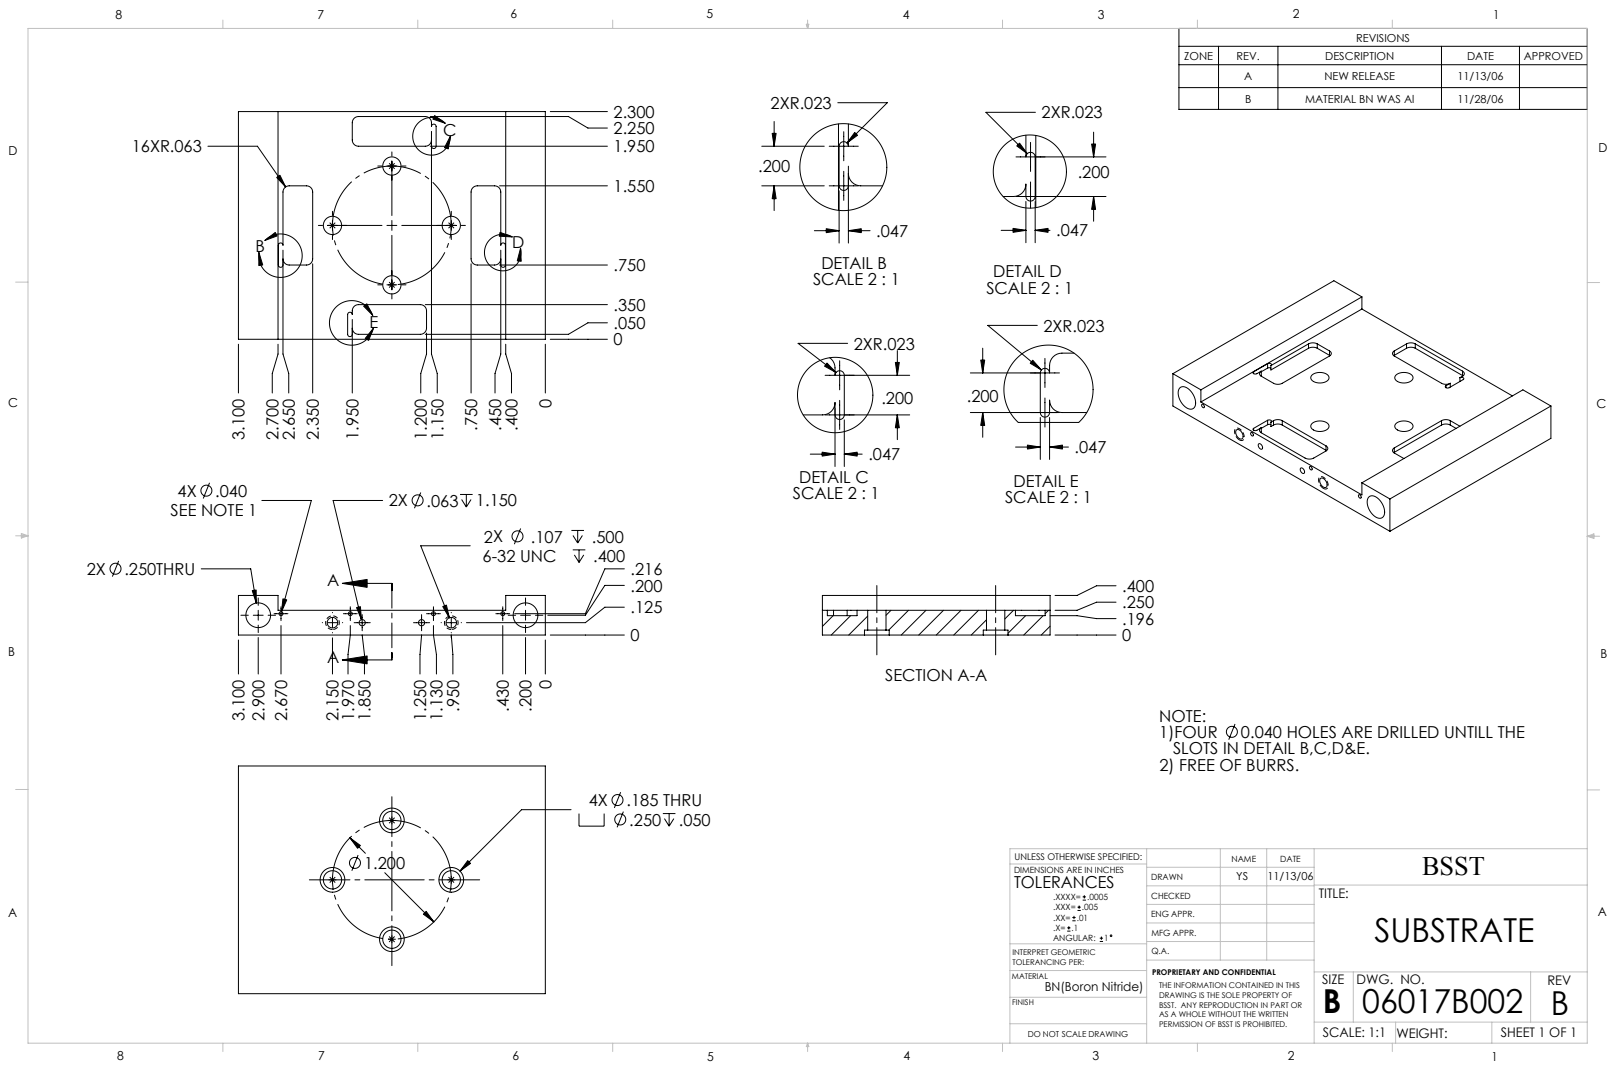
[picture p40: page 1]
2X .250THRU; 6-32 UNC; 2X .063 1.150 4X .040 SEE NOTE 1; 4X .185 THRU; SECTION A-A; DETAIL B SCALE 2 : 1; DETAIL C SCALE 2 : 1; DETAIL D SCALE 2 : 1; DETAIL E SCALE 2 : 1; DWG. NO.; REV; SCALE: 1:1 WEIGHT:; SHEET 1 OF 1; 11/13/06 DIMENSIONS ARE IN INCHES; .XXXX= .0005 .XXX= .005 .XX= .01 .X= .1 ANGULAR: 1

ZONE | REV. | DESCRIPTION | DATE | APPROVED

A | NEW RELEASE | 11/13/06
B | MATERIAL BN WAS Al | 11/28/06

NOTE:
1)FOUR 0.040 HOLES ARE DRILLED UNTILL THE
SLOTS IN DETAIL B,C,D&E.
2) FREE OF BURRS.

UNLESS OTHERWISE SPECIFIED:
TOLERANCES

DRAWN
CHECKED
ENG APPR.
MFG APPR.
PROPRIETARY AND CONFIDENTIAL
THE INFORMATION CONTAINED IN THIS
DRAWING IS THE SOLE PROPERTY OF
BSST. ANY REPRODUCTION IN PART OR
AS A WHOLE WITHOUT THE WRITTEN
PERMISSION OF BSST IS PROHIBITED.

INTERPRET GEOMETRIC
TOLERANCING PER:
MATERIAL
BN(Boron Nitride)
FINISH

DO NOT SCALE DRAWING
