bobbymckinney/hall_measurement/(commit log)

2015-08-19 google drive sync with lab
    [hall_setup_cad.dwg]
2015-08-20 corrected check contacts issue with soucing voltage instead of current.
    [RT_HallEffectGUIv1.py]
2015-08-25 updated room temp program to switch souce meter back to current mode after initial check
2015-08-27 fixed check contacts routine to switch keithly sourcemeter back to current mode after running
    [RT_HallEffectGUIv1.py]
2015-08-31 rewrote measurement as a for loop same as resistivity and seebeck, moved processing to be concurrent with main application rather than post application
2015-08-31 Added in ability to stop more frequently. Also minor big fixes.
    [RT_HallEffectGUIv1.py, resistivitycalc.py]
2015-10-30 Changed .command to route to correct file
    [RT_HallEffectGUIv1.py]
2016-01-14 added matlab code and summary for modeling heat response for hight setup
2016-02-09 Modified Design to better utilize ceramic parts.
    [block1.SLDPRT, block2.SLDPRT, ceramic_flange_spacer.SLDPRT, ceramic_round.SLDPRT, ceramic_spacers.SLDPRT, ceramic_standoff_small.SLDPRT, ceramic_standoff_wide.SLDPRT, ceramic_washer_large.SLDPRT]
